d4eh0/vehicle-lamp-ecu/docs/[SWE.1]requirements.md

# SWE.1 소프트웨어 요구사항

상태: 검토 초안. 미결 인터페이스·자원 조건 확정 전 기준선 미설정.
입력: [프로젝트 기능 목표·실행 환경](project-scope.md), [CAN 계약]([SWE.2]can-interface.md), [HW/SW 인터페이스](hardware-software-interface.md).

우선순위: 아래 기능·성능 항목 필수. Wokwi 예제·HIL 자동화 환경은 별도 지원 작업.

| ID | 조건·필수 동작 | 프로젝트 입력 | 예정 확인 방법 |
|---|---|---|---|
| SWR-001 | CAN 표준 데이터 프레임, ID 0x100·DLC 1·500 kbit/s의 LAMP_COMMAND 해석. 확장·원격·FD·오류 프레임의 명령 적용 금지 | PRJ-001,014 | 프레임 메타데이터·바이트 해석 검사, 보드 설정 확인 |
| SWR-002 | TURN=3 또는 RESERVED=1의 메시지 전체 거부·오류 기록. 일부 신호 갱신 금지 | PRJ-011,012 | 무효 입력 전후의 명령·로그 비교 |
| SWR-003 | 유효 메시지의 여섯 입력·마지막 유효 수신 시각 갱신. 무효 메시지 수신 시 갱신 금지, 두절 전까지 이전 명령 제어 유지 | PRJ-001,011,013,014 | 정상·무효 프레임과 모의 시각 조합 |
| SWR-004 | IGN ON·HAZARD OFF: LEFT는 좌측만, RIGHT는 우측만 점멸. TURN OFF는 양쪽 소등 | PRJ-002,008 | 입력 조합별 좌우 출력 검사 |
| SWR-005 | HAZARD ON: IGN·TURN과 관계없이 좌우 동기 점멸. IGN 변경에 따른 HAZARD 상태 변경 금지 | PRJ-003,008,009 | 비상등 중 IGN·TURN 변경 검사 |
| SWR-006 | 연속 점멸 ON·OFF 각각 400±20 ms. 모드 전환으로 잘린 구간 제외 | PRJ-004 | PC 모의 시각 검사 및 보드 파형 측정 |
| SWR-007 | 활성 모드 변경 시 ON 시작·점멸 기준 시각 초기화. HAZARD 해제 시 현재 IGN·TURN 재평가. 동일 모드 반복 수신 시 위상 유지 | PRJ-003,004,009 | 반복 수신·좌우 전환·비상등 해제 검사 |
| SWR-008 | TAIL/BRAKE 조합별 아래 출력표 준수. BRAKE 우선 | PRJ-005,006 | 네 입력 조합 검사 |
| SWR-009 | 미등 단독: 듀티 18~22%·950~1050 Hz. BRAKE ON: 공용 출력 연속 ON | PRJ-005 | PWM 설정·보드 파형 측정 |
| SWR-010 | IGN ON·REVERSE=1일 때만 후진 출력 ON. 다른 허용 기능과 동시 동작 | PRJ-007,008 | 입력 조합·동시 요청 검사 |
| SWR-011 | IGN OFF: 일반 방향지시·후진 OFF, 비상등·미등·제동 허용. IGN ON 복귀 시 최신 TURN·REVERSE 적용 | PRJ-008,009,015 | IGN 전환 전후 출력 검사 |
| SWR-012 | SW 출력 제어 가능 시점부터 최초 유효 명령 전까지 6채널 OFF. 리셋 중 기본 OFF는 회로 조건 | PRJ-010 | 초기화 경로 확인 및 부팅 출력 관측 |
| SWR-013 | 마지막 유효 명령 후 200 ms 무수신 시 통신 두절·6채널 OFF. 무효 프레임 반복에 따른 판정 지연 금지 | PRJ-013 | 모의 시각 경계 검사 및 보드 관측 |
| SWR-014 | 통신 복구 후 첫 유효 명령 적용. 가상 고장 채널 OFF 유지 | PRJ-009,012,013 | 통신 두절·복구와 가상 고장 조합 |
| SWR-015 | 통신 두절 판정 시 진단 LED 5회 점멸·오류 기록. 진단 점멸로 인한 수신·복구 지연 금지 | PRJ-012,013 | 로그·점멸 횟수·점멸 중 복구 검사 |
| SWR-016 | 시험 빌드의 UART 채널 고장 설정·CLEAR, PC 시험의 동일 진단 경로 호출 지원 | PRJ-012 | UART 및 PC 진단 입력 검사 |
| SWR-017 | 가상 고장 채널만 CLEAR 전까지 OFF. 해제 시 최신 명령 재평가, 통신 두절·최초 수신 전이면 OFF 유지 | PRJ-012,013 | 채널별 고장·CLEAR·통신 상태 조합 |
| SWR-018 | 오류 코드·채널·발생/해제·시각의 최근 16건 RAM 저장, 초과 시 오래된 기록 덮어쓰기. 재부팅 시 기록·가상 고장 초기화 | PRJ-012 | 16건 초과 기록·재부팅 검사 |
| SWR-019 | 정상 통신·무고장·출력 변경 신규 요청: 유효 CAN 수신 완료→출력 최초 변경 ≤10 ms | PRJ-002,003,016 | 보드에서 수신·출력 시각 계측 |

| TAIL | BRAKE | TAIL_STOP_L/R | CHMSL |
|---|---|---|---|
| 0 | 0 | OFF | OFF |
| 1 | 0 | PWM 20%, 1 kHz | OFF |
| 0 | 1 | 연속 ON | ON |
| 1 | 1 | 연속 ON | ON |

## 환경 영향·실현 가능성

| 항목 | 분석·후속 확인 |
|---|---|
| CAN 수신 | 동일 상태 반복 수신과 무효 프레임의 분리. 무효 프레임 폭주 시 처리 시간·큐 정책 검토 필요 |
| 시각·응답 | 비차단 점멸·두절 판정 필요. 실제 실행 주기와 최악 처리 시간은 SWE.2~3에서 확정 |
| RAM | 최근 16건 기록·최신 명령·수신 버퍼 사용. 상세 구조체 크기와 링크 맵 확인 예정 |
| PWM | 두 공용 램프의 듀티·주파수 조건. 타이머·GPIO 배정과 실물 측정 필요 |
| 입력 범위 | HAZARD는 이벤트가 아닌 현재 상태. IGN OFF의 TURN·REVERSE 값도 수신 가능 |
| HW 영향 | 리셋 중 OFF·LED 전류·3.3 V 논리 호환은 회로 조건. SW 시험만으로 확인 불가 |
| 전체 응답 | 물리 입력→출력 50 ms는 외부 BCM 처리·CAN 전달 포함. ECU 10 ms와 별도 관측 |

## 미결 항목

- 진단 LED ON/OFF 간격, 복구 시 잔여 점멸 처리, 지속 두절의 중복 로그 정책
- UART 명령 문법·채널 이름·오류 응답
- 최초 수신 전 진단 타임아웃 정책, 200 ms 경계의 처리·판정 해상도
- CAN 수신 버퍼 용량·초과 정책, 실제 핀·클럭·타이머 배정

[요구사항 연결표]([SWE.1]traceability.md). 확인 방법은 시험 계획 초안이며 수행 결과 제외.
