d4eh0/vehicle-lamp-ecu/TASK.md

# 작업 목록

| 단계 | 현재 상태 |
|---|---|
| SWE.1 | SW 요구사항 19개와 연결표 초안. UART 진단 정책 등 미결 |
| SWE.2 | 정적·동적 아키텍처, DBC와 SavvyCAN·cantools 검토 기록 |
| SWE.3 | CubeMX 설정, GPIO·PWM·CAN 해석·램프 제어 코드. CAN 실물 연동 디버깅 중 |
| SWE.4~6 | 단위·통합·요구사항 기반 검증 미실행 |
| HWE.1 | 외부 회로 요구사항 초안 |
| HWE.2 | LED 구동부·트랜시버 실물 배선. KiCad 회로도·BOM·ERC 예정 |

## 다음 작업

- [ ] CAN 정상 프레임 수신과 램프 연동 문제 해결
- [ ] 자동 명령 순서, 200ms 두절 소등·복구 동작 확인 및 기록
- [ ] UNO Q 스위치 입력·디바운싱 연결
- [ ] UART 가상 고장·CLEAR·16건 로그·진단 LED 구현
- [ ] 제어 로직과 HAL 입출력 분리, 상세 설계·요구사항 연결표 갱신
- [ ] KiCad 회로도·BOM·전류 계산·ERC
- [ ] SWE.4 단위 검증 → SWE.5 통합 검증 → SWE.6 요구사항 검증

## 검증 도구 계획

SIL은 실제 제어 코드에 모의 입력·시각을 적용하는 환경으로 구성 예정.
HIL·Wokwi·CANoe/CAPL은 미사용. 실물 수동 확인을 HIL 또는 SWE.4~6 완료로 분류하지 않음.

현재 실행 상태와 핀 연결: [펌웨어 안내](firmware/README.md).
