d4eh0/vehicle-lamp-ecu/docs/[SWE.1]traceability.md

# 요구사항 연결표

프로젝트 입력 → SW 요구사항 → 설계 컴포넌트 → 시험.
아래 컴포넌트는 설계 할당 초안, 시험 ID·실행 결과는 미작성.

| SW 요구사항 | 프로젝트 입력 | 설계 컴포넌트 | 시험 ID |
|---|---|---|---|
| SWR-001 | PRJ-001,014 | CanPort / CommandRx | 미작성 |
| SWR-002 | PRJ-011,012 | CommandRx / Diagnostics | 미작성 |
| SWR-003 | PRJ-001,011,013,014 | CommandRx | 미작성 |
| SWR-004 | PRJ-002,008 | LampControl | 미작성 |
| SWR-005 | PRJ-003,008,009 | LampControl | 미작성 |
| SWR-006 | PRJ-004 | LampControl | 미작성 |
| SWR-007 | PRJ-003,004,009 | LampControl | 미작성 |
| SWR-008 | PRJ-005,006 | LampControl | 미작성 |
| SWR-009 | PRJ-005 | OutputPort | 미작성 |
| SWR-010 | PRJ-007,008 | LampControl | 미작성 |
| SWR-011 | PRJ-008,009,015 | LampControl | 미작성 |
| SWR-012 | PRJ-010 | AppLoop / OutputPort | 미작성 |
| SWR-013 | PRJ-013 | CommandRx / AppLoop | 미작성 |
| SWR-014 | PRJ-009,012,013 | AppLoop / Diagnostics | 미작성 |
| SWR-015 | PRJ-012,013 | Diagnostics | 미작성 |
| SWR-016 | PRJ-012 | UartPort / Diagnostics | 미작성 |
| SWR-017 | PRJ-012,013 | Diagnostics / AppLoop | 미작성 |
| SWR-018 | PRJ-012 | Diagnostics | 미작성 |
| SWR-019 | PRJ-002,003,016 | AppLoop / CanPort / OutputPort | 미작성 |

HW 요구사항은 [HWE.1]([HWE.1]requirements.md)에서 프로젝트 입력과 연결.
프로젝트 입력 전체의 할당 누락·과도한 할당 검토, 코드·실행 결과 연결은 후속 작업.
