d4eh0/vehicle-lamp-ecu/docs/images/lamp-output.jpg

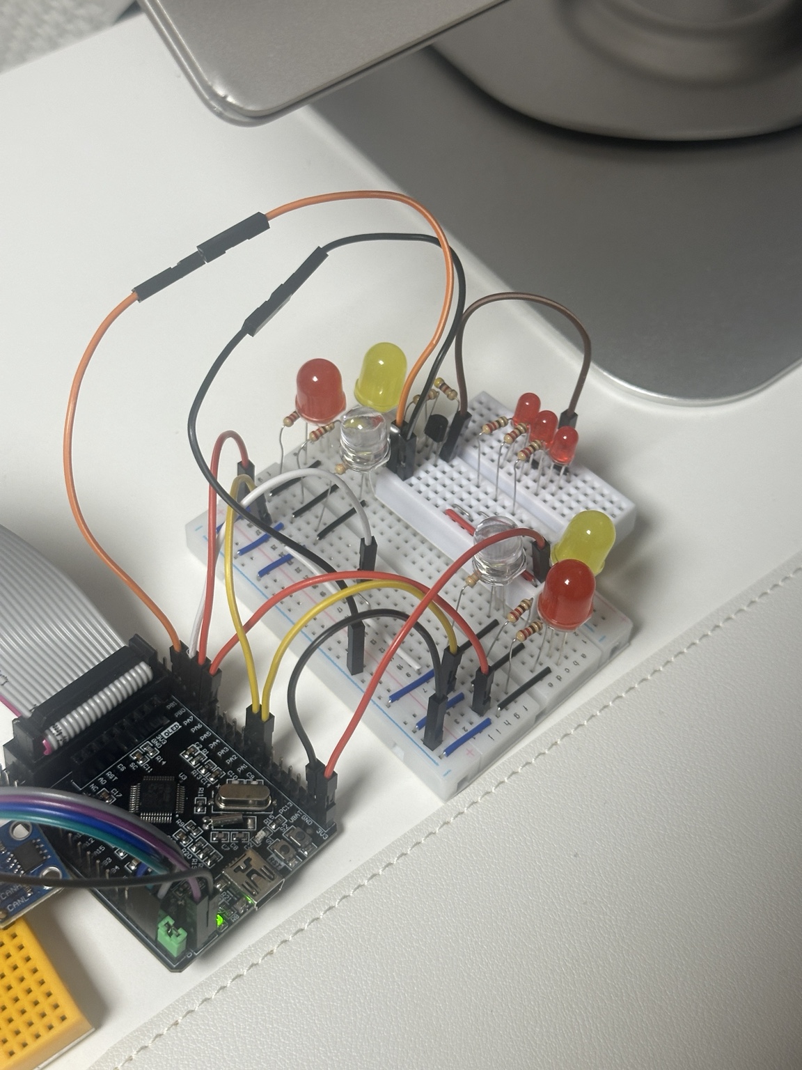
docs/images/lamp-output.jpg
