d4eh0/vehicle-lamp-ecu/docs/images/workbench.jpg

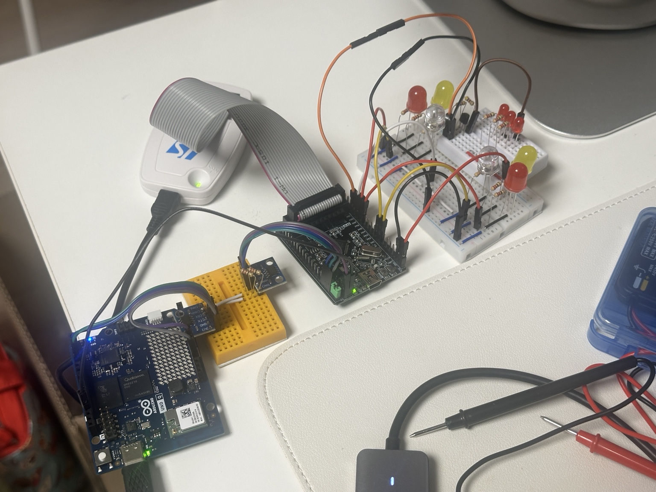
docs/images/workbench.jpg
