d4eh0/vehicle-lamp-ecu/docs/parts.md

# 보유 장비 및 부품

## 1. 보유 장비

| 품목 | 규격 |
|---|---|
| STM32 개발보드 | STM32F103C8T6 개발보드 — 모델·헤더 확인 필요 |
| Arduino UNO Q | 4GB 모델 |
| ST-LINK V2 | 디버거/프로그래머 |
| 멀티미터 | 아사히 4201 |

## 2. 기존 부품 키트

고추 건조기 프로젝트를 위해 구매한 부품 세트. 구성품별 잔여 수량은 확인하지 않았다.

| No. | 품목 | 규격 |
|---:|---|---|
| 1 | FND 모듈 | — |
| 2 | 가변저항 | 10kΩ |
| 3 | 택트 스위치 | — |
| 4 | 슬라이드 스위치 | — |
| 5 | 브레드보드 | — |
| 6 | 점퍼선 | M-M |
| 7 | 점퍼선 | M-F |
| 8 | 점퍼선 | F-F |
| 9 | 전해 커패시터 | 100µF, 25V |
| 10 | 온도 센서 모듈 | — |
| 11 | FTDI USB-TTL | — |
| 12 | OLED 모듈 | I²C |
| 13 | LED | — |
| 14 | 저항 | 220Ω |
| 15 | 저항 | 4.7kΩ |
| 16 | 부품 보관함 | — |
| 17 | MicroSD 소켓 모듈 | — |
| 18 | NPN 트랜지스터 | 2N3904 |
| 19 | 저항 | 1kΩ |
| 20 | 핀 헤더 | 2.54mm 2×3 |
| 21 | 릴레이 | 5V |
| 22 | 납 | — |
| 23 | 소켓 | — |
| 24 | 전선 | 50cm |
| 25 | 콘센트 | — |

- 구매 상품: https://m.smartstore.naver.com/oj-store/products/6224170074

## 3. 추가 구매 부품 — 2026-10-27 주문

네이버 주문/배송내역에서 **10월 27일 08:11의 첫 번째 주문(배송완료)**만 기록했다. 같은 상품이 여러 번 나타난 경우 하나로 묶었다.

| No. | 품목 | 규격·상품명 | 주문내역 항목 수 |
|---:|---|---|---:|
| 1 | LED 푸시버튼 | R16-503 GREEN / UNLOCK | 1 |
| 2 | 리미트 스위치 | 아두이노 리미트 스위치 모듈 | 1 |
| 3 | LED 푸시버튼 | R16-503 RED / LOCK | 1 |
| 4 | 저항 | 1/4W, 1kΩ (10개 단위) | 8 |
| 5 | 적외선 센서 | 라인트레이서·장애물 회피 근접감지 모듈 | 1 |
| 6 | 초음파 센서 브래킷 | HC-SR04용 | 1 |
| 7 | 초음파 센서 | HC-SR04P, 3~5.5V 호환 | 1 |
| 8 | 로봇 프레임 | 4WD RC카 자동차 로봇 프레임 세트 | 1 |
| 9 | 가속도·자이로 센서 | GY-521 / MPU6050, 3축+3축 | 1 |
| 10 | 로커 스위치 | KCD1-102, 2단 I/O | 1 |
| 11 | 토글 스위치 | MTS-203, 6핀 3단 | 1 |
| 12 | LED | 5mm 고휘도, 색상별 옵션 | 5 |
| 13 | RGB LED | 5mm, 4핀, 공통 애노드/캐소드 옵션 | 2 |
| 14 | 브레드보드 | 미니 170핀, 투명 | 1 |
| 15 | 점퍼선 세트 | 브레드보드 점퍼선 140PCS | 1 |
| 16 | 브레드보드 | 미니 25핀 | 1 |
| 17 | 정밀 드라이버 | 샤오미 호환 24종 세트 | 1 |
| 18 | 점퍼 케이블 | FF 40P, 10cm | 3 |
| 19 | 서보모터 | MG90S, 180도 | 1 |
| 20 | 만능기판 | PCB 양면 에폭시, 5×7cm | 1 |
| 21 | 모터 드라이버 | TB6612FNG, 듀얼 DC 모터 | 1 |
| 22 | 전류 센서 | INA219 DC 전류 센서 | 1 |
| 23 | ESP32 보드 | ESP32 WROOM-32, USB-C, CH340 | 1 |
| 24 | LED | 10mm, 색상별 옵션 | 5 |
| 25 | 브레드보드 | MB-102, 830핀 | 1 |
| 26 | 브레드보드 | 170홀 흰색 | 1 |
| 27 | 브레드보드 | 400핀 투명 | 1 |
| 28 | 브레드보드 | 400홀 JD-06 | 1 |
| 29 | CAN 트랜시버 | SN65HVD230 CAN BUS 모듈 | 1 |
| 30 | 브레드보드 | 미니 170핀, 노랑 | 1 |

- 첫 번째 주문: **48개 항목, 중복을 합친 30종**.
- 위 숫자는 주문 화면에 표시된 **상품 항목 수**이며 실제 개별 부품 개수나 남은 재고량이 아니다. 세트 구성·옵션·실제 주문 수량은 별도 확인이 필요하다.
- 주문 화면에 각 LED의 색상 옵션 등이 나타나지 않아 구체적인 색상·수량을 임의로 지정하지 않았다.
- **취소 완료된 두 번째 주문 및 그 아래의 다른 주문은 포함하지 않았다.**
