d4eh0/vehicle-lamp-ecu/docs/images/can-wiring.jpg

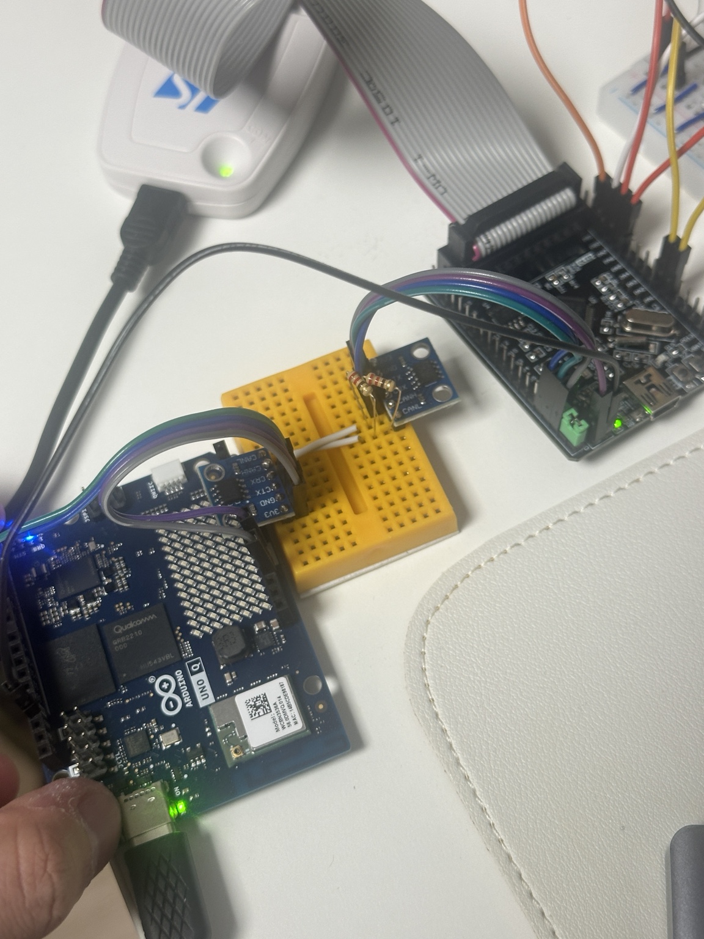
docs/images/can-wiring.jpg
