d4eh0/vehicle-lamp-ecu/firmware/rear_lamp_ecu/Core/Src/main.c

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
/* Includes ------------------------------------------------------------------*/
#include "main.h"

CAN_HandleTypeDef hcan;

TIM_HandleTypeDef htim3;

UART_HandleTypeDef huart1;

void SystemClock_Config(void);
static void MX_GPIO_Init(void);
static void MX_CAN_Init(void);
static void MX_TIM3_Init(void);
static void MX_USART1_UART_Init(void);
/* USER CODE BEGIN 0 */
static uint8_t lampCommand = 0;
static uint8_t commandReceived = 0;
static uint8_t previousMode = 0;

static uint32_t lastCommandTick = 0;
static uint32_t blinkStartTick = 0;

/* 0x100, 표준 데이터 프레임, DLC 1만 유효 */
static void ReceiveCommand(void)
{
    CAN_RxHeaderTypeDef header;
    uint8_t data[8];

    /* 한 번에 최대 3개 처리: 출력 제어가 밀리지 않도록 제한 */
    for (uint8_t i = 0; i < 3; i++)
    {
        if (HAL_CAN_GetRxFifoFillLevel(&hcan, CAN_RX_FIFO0) == 0)
            break;

        if (HAL_CAN_GetRxMessage(
                &hcan, CAN_RX_FIFO0, &header, data) != HAL_OK)
            break;

        if (header.IDE != CAN_ID_STD ||
            header.RTR != CAN_RTR_DATA ||
            header.StdId != 0x100U ||
            header.DLC != 1U)
            continue;

        uint8_t turn = (data[0] >> 1) & 0x03U;

        /* TURN=3 또는 예약 비트=1이면 명령 전체 무효 */
        if (turn == 3U || (data[0] & 0x80U) != 0U)
            continue;

        lampCommand = data[0];
        lastCommandTick = HAL_GetTick();
        commandReceived = 1;
    }
}

static void UpdateLamps(void)
{
    uint32_t now = HAL_GetTick();

    uint8_t valid =
        commandReceived &&
        ((uint32_t)(now - lastCommandTick) < 200U);

    uint8_t command = valid ? lampCommand : 0U;

    uint8_t ign     = command & 0x01U;
    uint8_t turn    = (command >> 1) & 0x03U;
    uint8_t hazard  = (command >> 3) & 0x01U;
    uint8_t tail    = (command >> 4) & 0x01U;
    uint8_t brake   = (command >> 5) & 0x01U;
    uint8_t reverse = (command >> 6) & 0x01U;

    /* 0=OFF, 1=LEFT, 2=RIGHT, 3=HAZARD */
    uint8_t mode = hazard ? 3U : (ign ? turn : 0U);

    /* 모드가 바뀔 때만 점멸 위상 초기화 */
    if (mode != previousMode)
    {
        blinkStartTick = now;
        previousMode = mode;
    }

    uint8_t blinkOn =
        (((uint32_t)(now - blinkStartTick) / 400U) & 1U) == 0U;

    uint8_t leftOn =
        blinkOn && (mode == 1U || mode == 3U);

    uint8_t rightOn =
        blinkOn && (mode == 2U || mode == 3U);

    HAL_GPIO_WritePin(
        TURN_L_GPIO_Port, TURN_L_Pin,
        leftOn ? GPIO_PIN_SET : GPIO_PIN_RESET);

    HAL_GPIO_WritePin(
        TURN_R_GPIO_Port, TURN_R_Pin,
        rightOn ? GPIO_PIN_SET : GPIO_PIN_RESET);

    /* ARR=999: 미등 20%, 제동 100%. 제동 우선 */
    uint32_t duty = brake ? 1000U : (tail ? 200U : 0U);

    __HAL_TIM_SET_COMPARE(&htim3, TIM_CHANNEL_1, duty);
    __HAL_TIM_SET_COMPARE(&htim3, TIM_CHANNEL_2, duty);

    HAL_GPIO_WritePin(
        REVERSE_LAMP_GPIO_Port, REVERSE_LAMP_Pin,
        (ign && reverse) ? GPIO_PIN_SET : GPIO_PIN_RESET);

    HAL_GPIO_WritePin(
        CHMSL_GPIO_Port, CHMSL_Pin,
        brake ? GPIO_PIN_SET : GPIO_PIN_RESET);
}
/* USER CODE END 0 */

/**
  * @brief  The application entry point.
  * @retval int
  */
int main(void)
{

  /* MCU Configuration--------------------------------------------------------*/

  /* Reset of all peripherals, Initializes the Flash interface and the Systick. */
  HAL_Init();

  /* Configure the system clock */
  SystemClock_Config();

  /* Initialize all configured peripherals */
  MX_GPIO_Init();
  MX_CAN_Init();
  MX_TIM3_Init();
  MX_USART1_UART_Init();
  /* USER CODE BEGIN 2 */

  /* 시작 시 모든 출력 OFF */
  HAL_GPIO_WritePin(TURN_L_GPIO_Port, TURN_L_Pin, GPIO_PIN_RESET);
  HAL_GPIO_WritePin(TURN_R_GPIO_Port, TURN_R_Pin, GPIO_PIN_RESET);
  HAL_GPIO_WritePin(REVERSE_LAMP_GPIO_Port,
                    REVERSE_LAMP_Pin, GPIO_PIN_RESET);
  HAL_GPIO_WritePin(CHMSL_GPIO_Port, CHMSL_Pin, GPIO_PIN_RESET);

  __HAL_TIM_SET_COMPARE(&htim3, TIM_CHANNEL_1, 0);
  __HAL_TIM_SET_COMPARE(&htim3, TIM_CHANNEL_2, 0);

  if (HAL_TIM_PWM_Start(&htim3, TIM_CHANNEL_1) != HAL_OK ||
      HAL_TIM_PWM_Start(&htim3, TIM_CHANNEL_2) != HAL_OK)
  {
      Error_Handler();
  }

  /* 수신 필터: 일단 수신하고 ReceiveCommand에서 유효성 판단 */
  CAN_FilterTypeDef filter = {0};

  filter.FilterBank = 0;
  filter.FilterMode = CAN_FILTERMODE_IDMASK;
  filter.FilterScale = CAN_FILTERSCALE_32BIT;
  filter.FilterFIFOAssignment = CAN_RX_FIFO0;
  filter.FilterActivation = ENABLE;
  filter.SlaveStartFilterBank = 14;

  if (HAL_CAN_ConfigFilter(&hcan, &filter) != HAL_OK ||
      HAL_CAN_Start(&hcan) != HAL_OK)
  {
      Error_Handler();
  }
  /* USER CODE END 2 */

  /* Infinite loop */
  /* USER CODE BEGIN WHILE */
  while (1)
  {
    /* USER CODE END WHILE */

    /* USER CODE BEGIN 3 */
	  ReceiveCommand();
	  UpdateLamps();
  }
  /* USER CODE END 3 */
}

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
