d4eh0/vehicle-lamp-ecu/firmware/rear_lamp_ecu/Core/Inc/main.h

#define TURN_L_Pin GPIO_PIN_0
#define TURN_L_GPIO_Port GPIOA
#define TURN_R_Pin GPIO_PIN_1
#define TURN_R_GPIO_Port GPIOA
#define REVERSE_LAMP_Pin GPIO_PIN_0
#define REVERSE_LAMP_GPIO_Port GPIOB
#define CHMSL_Pin GPIO_PIN_1
#define CHMSL_GPIO_Port GPIOB
#define DIAG_LED_Pin GPIO_PIN_12
#define DIAG_LED_GPIO_Port GPIOB
