d4eh0/vehicle-lamp-ecu/(commit log)

2026-10-28 chore: 저장소 초기화
2026-10-28 docs: SWE·HWE 개발 범위와 산출물 계획
    - SWE.1~6·HWE.1~2 범위
    - 도구별 산출물·예정 시험 환경
2026-10-28 docs: 소프트웨어 개발 범위와 입출력 정의
    - ECU 소프트웨어·외부 BCM 책임
    - 램프 6채널·제외 기능
2026-10-28 docs: [SWE.1] 램프 제어 기능 요구사항
    - 방향지시·비상등·미등·제동·후진·CHMSL의 SW 동작 조건
2026-10-28 docs: [SWE.1] 동작 조건과 실행 환경 제약
    - IGN·초기화·입력 유지 조건
    - 전원·회로 책임의 별도 구분
2026-10-29 docs: [SWE.1] CAN 입력과 통신 장애 요구사항
    - 유효 메시지·갱신 조건
    - 200 ms 두절·최초 수신·복구
2026-10-29 docs: [SWE.1] 점멸·PWM·응답시간 요구사항
    - 400 ms 점멸·미등 PWM·ECU 10 ms 목표
    - 외부 구간 포함 50 ms 목표의 구분
2026-10-29 docs: [SWE.1] 가상 고장과 오류 기록 요구사항
    - 시험 UART 고장 설정·CLEAR
    - 채널 OFF·최근 16건 RAM 기록
2026-10-29 docs: 개발보드와 보유 부품 목록
    - 개발보드·트랜시버·보유 부품
    - 실제 회로 BOM과 구분
2026-10-29 docs: 요구사항 연결표와 개발 문서 목차
    - 프로젝트 입력–SW/HW 요구사항–설계 연결
    - 장문 회고 대신 선택 근거 표
2026-10-29 docs: 소프트웨어 입출력 환경 구성도
    - 기존 diagrams.net 환경 그림 보존
    - BCM·ECU·외부 램프 경계
2026-10-29 docs: SWE·HWE 작업 순서와 완료 기준
    - SW 요구사항·컴포넌트·유닛·검증
    - 외부 회로 요구사항·설계
2026-10-31 docs: 실행 환경과 외부 인터페이스 구성도
    - 기존 장치 구성 그림 보존
    - BCM·ECU·CAN·램프·진단 연결 관계
2026-10-31 docs: [SWE.1] 명령·장애·복구 동작 시나리오
    - 정상 명령·통신 두절·재부팅·가상 고장 시나리오
    - SW 내부 컴포넌트 시퀀스와 구분
2026-10-31 docs: [SWE.2] CAN DBC와 SavvyCAN·cantools 검토 기록
    - DBC와 신호 계약
    - GUI 검토 화면·실행 가능한 오프라인 검사
2026-10-31 docs: [SWE.2] 소프트웨어 컴포넌트와 실행 흐름
    - CAN 수신·명령 해석·램프 제어·진단·출력 컴포넌트
    - 정적 구조와 정상·통신 복구·초기화·고장 주입 시퀀스
    - SW 요구사항 분석·설계 할당·SIL/HIL 검증 계획
2026-10-31 docs: [HWE.1] 외부 회로 요구사항과 설계 항목
    - 전원·CAN 종단·LED 구동·리셋 출력·디버깅 조건
    - HWE.2 KiCad 회로·BOM·설계 검토 항목
    - SWE·HWE 진행 상태와 도구별 산출물 목록
2026-10-31 docs: 다이어그램 원본 분리와 한글 설명 정리
    - diagrams/source로 draw.io 원본 4개 이동
    - SW 구성·시퀀스 설명 한글화
    - 미사용 SVG 10개 제거와 문서 링크 갱신
2026-11-01 feat: [SWE.3] 램프 제어 펌웨어와 실물 구성 정리
    - STM32 프로젝트와 UNO Q 자동 명령 송신 코드
    - 실물 사진, 전체 구성도와 설계 조건 중심 README
    - CAN 연동 디버깅 상태와 후속 작업 구분
