d4eh0/vehicle-lamp-ecu/(notices)

Notices in the files:
firmware/rear_lamp_ecu/Core/Inc/main.h:
Copyright (c) 2026 STMicroelectronics.
All rights reserved.
This software is licensed under terms that can be found in the LICENSE file
